NaLelqGoshkaFerarito/PINT/Pics/pcb3d.png

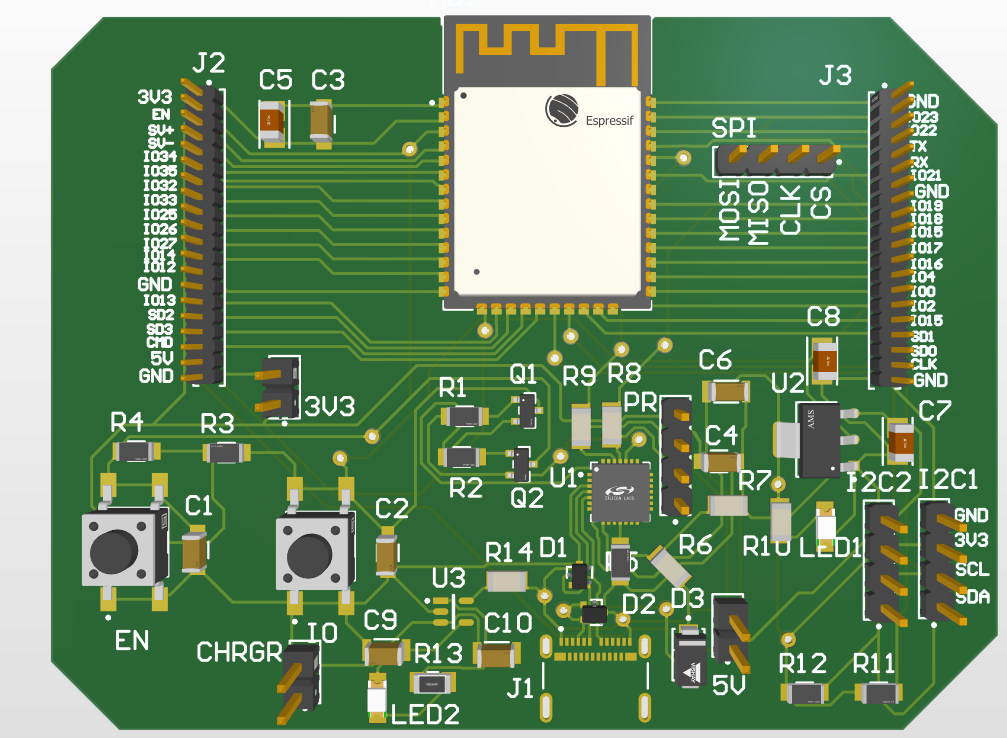
Pics/pcb3d.png
