NaLelqGoshkaFerarito/PINT/README.txt

Mic_circuit: Schematic and PCB for the microphone
PCB_Project: Main ESP32 board and schematic
Pics: Pictures of the main and the board
Sims: Simulations of the microphone
Vladislav82,8x62,36: Exports
Report: PDF version of the LaTeX report
