NaLelqGoshkaFerarito/PINT/Pics/bat_charger.png

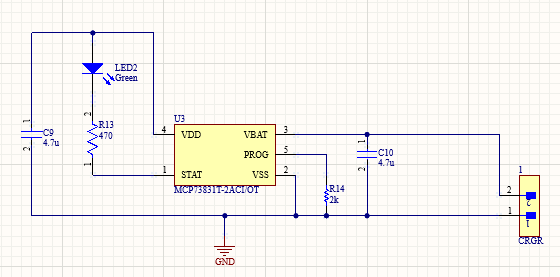
Pics/bat_charger.png
