NaLelqGoshkaFerarito/PINT/Pics/headers.png

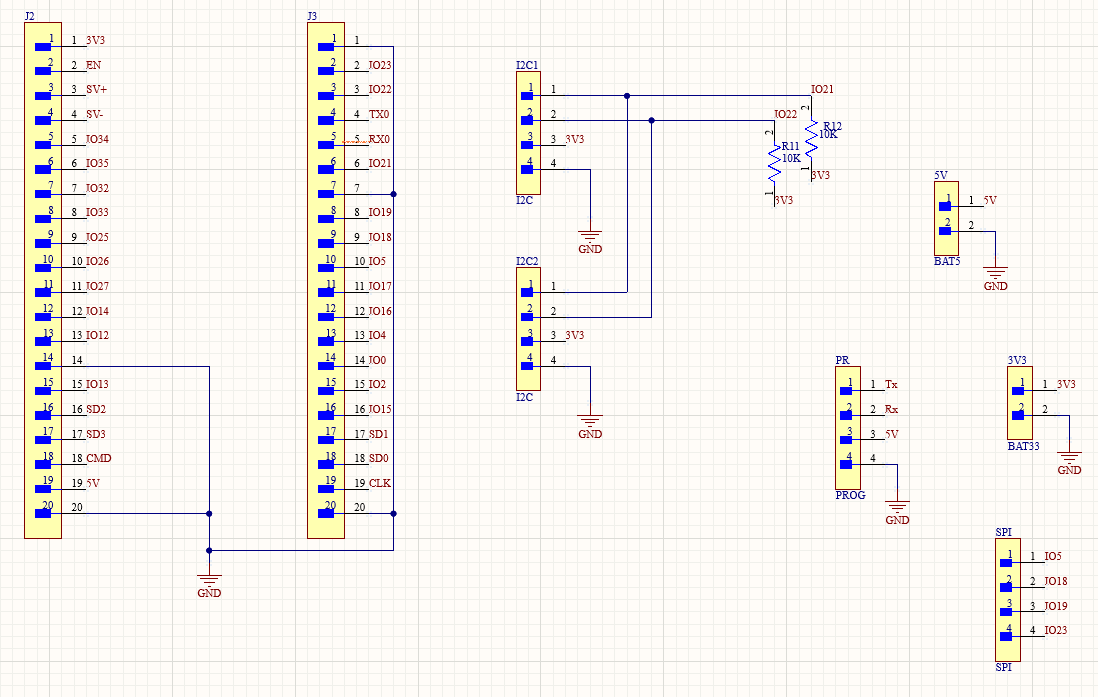
Pics/headers.png
