NaLelqGoshkaFerarito/PINT/Pics/mic_circuit.png

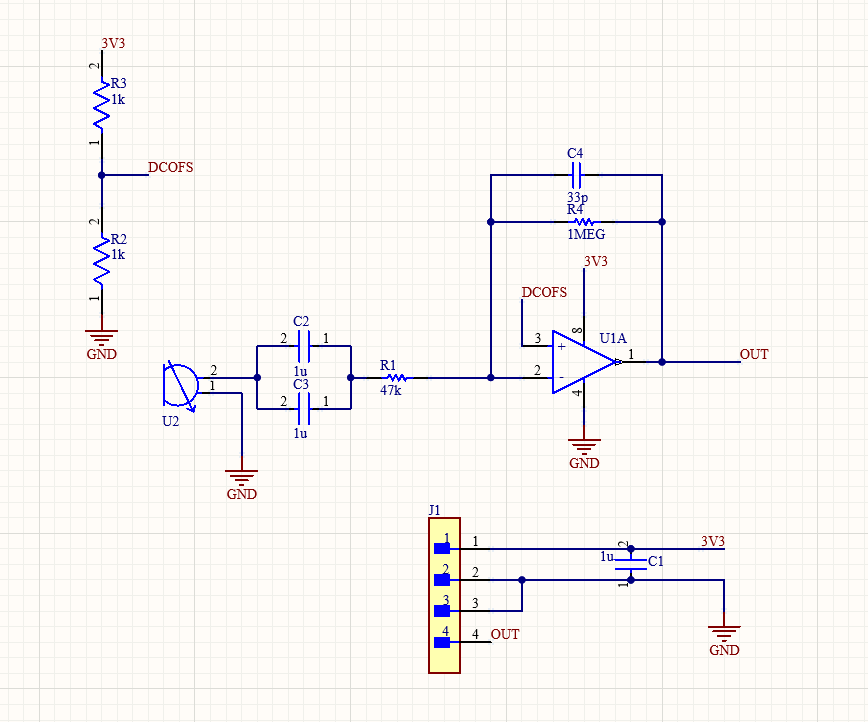
Pics/mic_circuit.png
