NaLelqGoshkaFerarito/PINT/Pics/mic_pcb.png

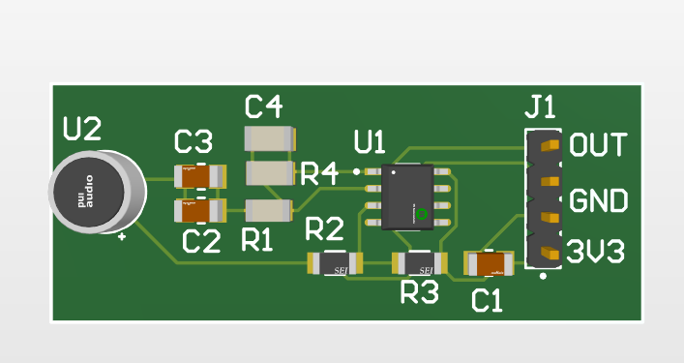
Pics/mic_pcb.png
