NaLelqGoshkaFerarito/PINT/Pics/pcb.png

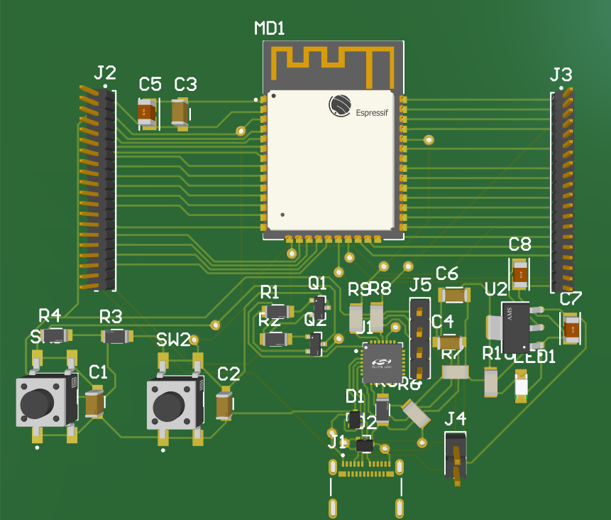
Pics/pcb.png
