NaLelqGoshkaFerarito/PINT/Pics/power_ext.png

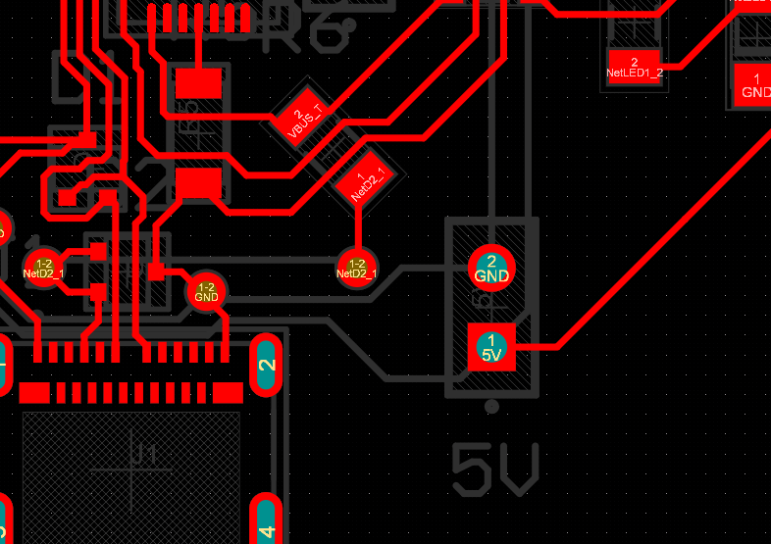
Pics/power_ext.png
