NaLelqGoshkaFerarito/PINT/Pics/power_ext_3v3.png

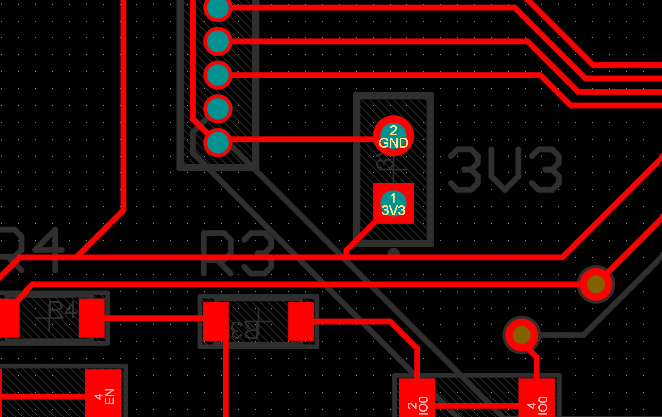
Pics/power_ext_3v3.png
