NaLelqGoshkaFerarito/PINT/Pics/power_supply.png

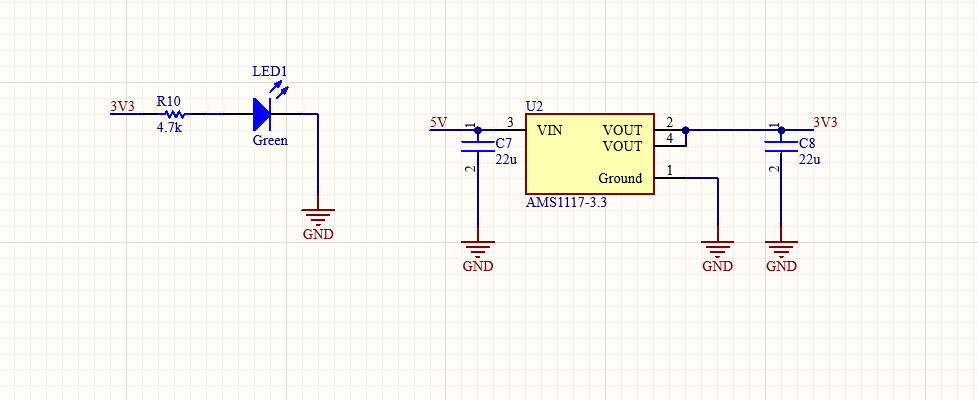
Pics/power_supply.png
