NaLelqGoshkaFerarito/PINT/Pics/programmer.png

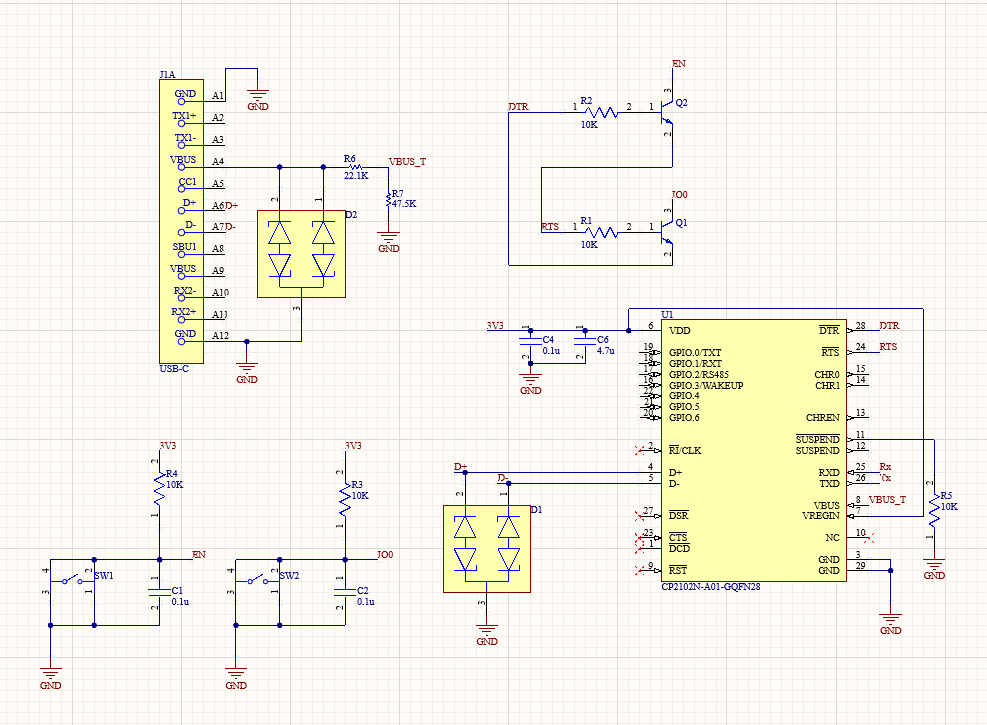
Pics/programmer.png
