NaLelqGoshkaFerarito/PINT/Pics/programmer_ext.png

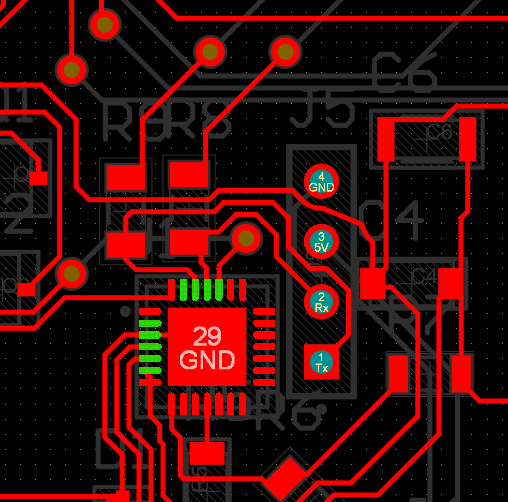
Pics/programmer_ext.png
