NaLelqGoshkaFerarito/PINT/Pics/serial_headers.png

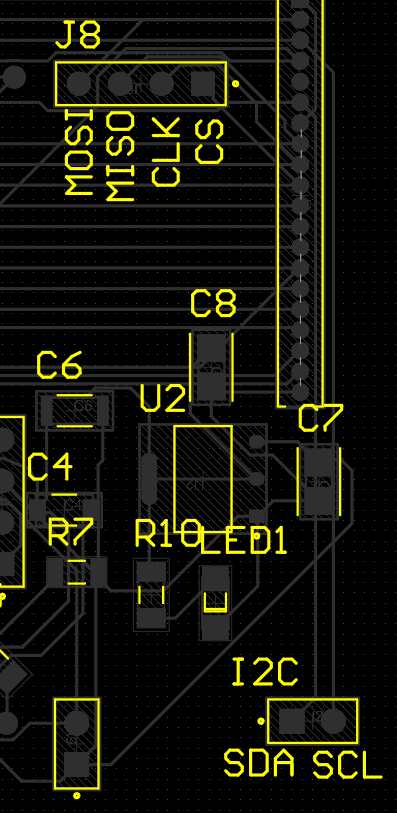
Pics/serial_headers.png
