NaLelqGoshkaFerarito/PINT/Pics/sim1.png

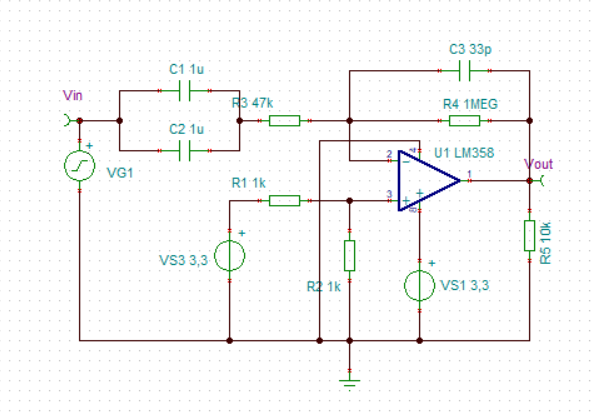
Pics/sim1.png
