NaLelqGoshkaFerarito/PINT/Pics/sim1_bode.png

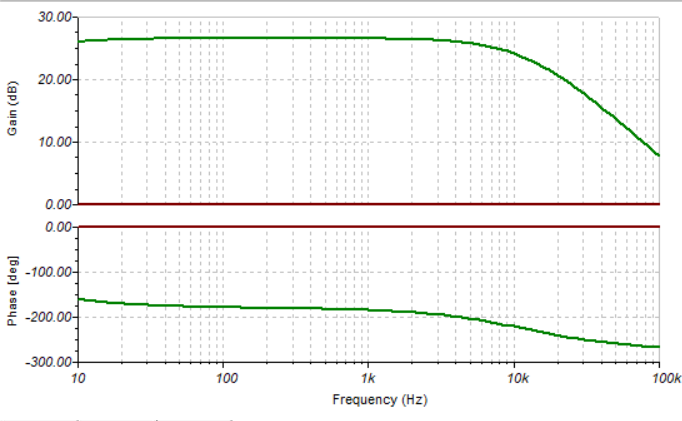
Pics/sim1_bode.png
