NaLelqGoshkaFerarito/PINT/Pics/sim1_out2.png

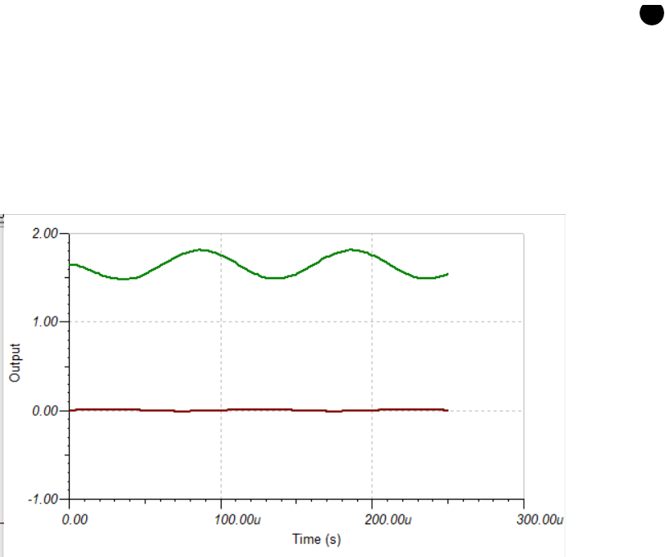
Pics/sim1_out2.png
