NaLelqGoshkaFerarito/PINT/Pics/sim1_out.png

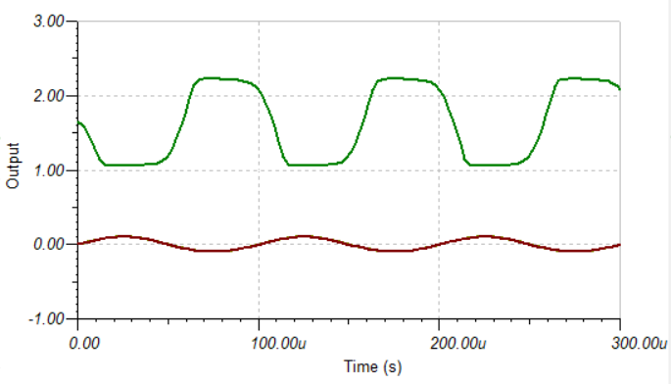
Pics/sim1_out.png
