NaLelqGoshkaFerarito/PINT/Pics/sim2_out1.png

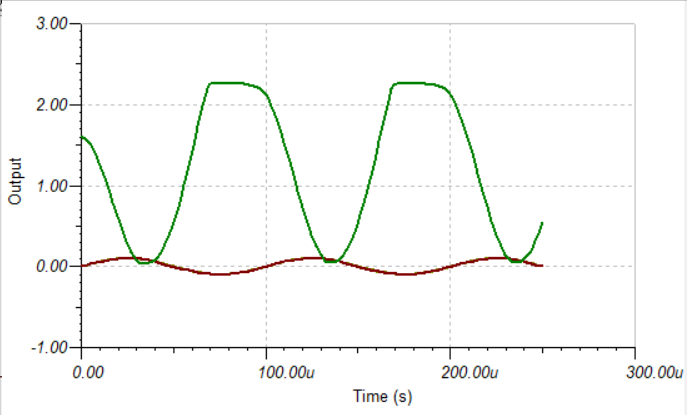
Pics/sim2_out1.png
