NaLelqGoshkaFerarito/PINT/(list of files, drawings)

Other design files:
Mic_Circuit/Mic_Circuit.PrjPcb
Mic_Circuit/PCB2.PcbDoc
Mic_Circuit/PCB2.SchDoc
PCB_Project/PCB1.PcbDoc
PCB_Project/PCB1.SchDoc
PCB_Project/PCB_Project.PrjPcb
