NaLelqGoshkaFerarito/PINT/(commit log)

2023-03-01 Base PCB complete - Created PCB model in Altium Designer - Added pictures
    [ESP32_509761.PrjPcb, PCB1.PcbDoc, PCB1.SchDoc, PCB_Project.PrjPcb, Schematic.SchDoc]
2023-03-01 Added I2C pullups
    [PCB1.PcbDoc, PCB1.SchDoc]
2023-03-03 Started microphone circuit - Sims - made a simulation for the microphone circuit - PINTSoloReport - added the steps taken to design the circuit - Mic_Circuit - started designing the microphone PCB
    [Mic_Circuit.PrjPcb, Mic_PCB2.PcbDoc, Mic_Schematic.SchDoc, PCB1.PcbDoc, PCB1.SchDoc]
2023-03-03 Changed opamp supply from -3V3 to GND in sim
2023-03-03 Created mic PCB
    [PCB2.PcbDoc, PCB2.SchDoc]
2023-03-03 Added documentation for the PCB
2023-03-06 Added pin markings
    [PCB1.PcbDoc, PCB2.PcbDoc]
2023-03-06 Added charging circuit (schematic only)
    [PCB1.PcbDoc, PCB1.SchDoc]
2023-03-07 Added charger to PCB
    [PCB1.PcbDoc, PCB1.SchDoc]
2023-03-08 Minor visual changes (documentation to be finished)
    [PCB1.PcbDoc, PCB1.SchDoc]
2023-03-12 Connected 5V net to charger circuit
    [PCB1.PcbDoc, PCB1.SchDoc]
2023-03-13 Added Gerber and NC drill files
    [ESP32_509761.PrjPcb, Mic_Circuit.PrjPcb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]
2023-03-13 Fixed a routing mistake, generated new output files
    [PCB1.GBL, PCB1.GBO, PCB1.GBP, PCB1.GBS, PCB1.GTL, PCB1.GTO, PCB1.GTP, PCB1.GTS]
